tfry-git/compressor-arduino/(commit log)

2017-05-04 First version.
    Essentials working, including compile-time configurable settings.
    Status indication and runtime configuration not yet implemented.
    Hardware description to follow, but the basic idea is very simple:
    - Connect pin A0 to audio in, biased to 2.5V
    - Connect pin D3 to the gate of two 2n7000 N-Fets, back to back, switchin the signal on an off at a high rate
2017-05-08 Fix release handling, and base calculations on ratio, directly, instead of inverse ratio.
    [compressor.ino]
2017-05-08 Add schematic for very basic circuit.
    This circuit is quite far from ideal, but good enough to show the
    basic idea. Some variants to follow.
2017-05-09 Adjust circuit for even more simplicity and robustness: - bias input to 3.3V stabilized - switch on audio ground, rather than audio signal - this also allows us to handle higher signal levels.
    Further add documentation on adding controls and tuning.
    [compressor.ino]
2017-05-09 We still depend on the body diode voltage drop, of course. Also, some small corrections and additions to the readme.
    [compressor.ino]
